DylanSlayton/Automated-Rock-Candy-Maker/Rock Candy Maker P&ID Spec Sheet Uploadable.xlsx

Sheet: Single Line Nozzle
Tag | Size | Spec | Description | Manufacturer | Model Number | Supplier | Comment | Class Name | PnPID | Status | Type | Number
N-1 |  |  | SINGLE LINE NOZZLE |  |  |  |  | Single Line Nozzle | 2215 | New | N | 1

Sheet: Flanged Nozzle
Tag | Size | Spec | Description | Manufacturer | Model Number | Supplier | Comment | Class Name | PnPID | Status | Type | Number
N-2 | 1/4" | NPT Brass | FLANGED NOZZLE |  |  |  |  | Flanged Nozzle | 2126 | New | N | 2
N-1 |  |  | FLANGED NOZZLE |  |  |  |  | Flanged Nozzle | 2396 | New | N | 1

Sheet: Assumed Nozzle
Tag | Size | Spec | Description | Manufacturer | Model Number | Supplier | Comment | Class Name | PnPID | Status | Type | Number
N-1 | 3/8" | Sch 40 PVC | ASSUMED NOZZLE |  |  |  |  | Assumed Nozzle | 2181 | New | N | 1
N-2 | 3/8" | Sch 40 PVC | ASSUMED NOZZLE |  |  |  |  | Assumed Nozzle | 2362 | New | N | 2

Sheet: Nozzles
Tag | Size | Spec | Description | Manufacturer | Model Number | Supplier | Comment | Class Name | PnPID | Status | Type | Number
N-2 | 1/4" | NPT Brass | FLANGED NOZZLE |  |  |  |  | Flanged Nozzle | 2126 | New | N | 2
N-1 | 3/8" | Sch 40 PVC | ASSUMED NOZZLE |  |  |  |  | Assumed Nozzle | 2181 | New | N | 1
N-1 |  |  | SINGLE LINE NOZZLE |  |  |  |  | Single Line Nozzle | 2215 | New | N | 1
N-2 | 3/8" | Sch 40 PVC | ASSUMED NOZZLE |  |  |  |  | Assumed Nozzle | 2362 | New | N | 2
N-1 |  |  | FLANGED NOZZLE |  |  |  |  | Flanged Nozzle | 2396 | New | N | 1

Sheet: Software Signal Line
Description | Manufacturer | Model Number | Supplier | Comment | Class Name | PnPID | Status | Tag | From | To
SOFTWARE SIGNAL LINE |  |  |  |  | Software Signal Line | 2654 | New | ? | 1-TALL-1 | 1-I-1?
SOFTWARE SIGNAL LINE |  |  |  |  | Software Signal Line | 2657 | New | ? | 1-TAL-1 | 1-I-2
SOFTWARE SIGNAL LINE |  |  |  |  | Software Signal Line | 2686 | New | ? | 1-I-2 | 1-I-3
SOFTWARE SIGNAL LINE |  |  |  |  | Software Signal Line | 2694 | New | ? | 1-I-3 | 1-I-4
SOFTWARE SIGNAL LINE |  |  |  |  | Software Signal Line | 2708 | New | ? |  | 1-I-5

Sheet: Instrument Supply
Description | Manufacturer | Model Number | Supplier | Comment | Class Name | PnPID | Status | Tag | From | To
INSTRUMENT SUPPLY |  |  |  |  | Instrument Supply | 2197 | New | ? |  | R-001

Sheet: Electrical Signal Line
Description | Manufacturer | Model Number | Supplier | Comment | Class Name | PnPID | Status | Tag | From | To
ELECTRICAL SIGNAL LINE |  |  |  |  | Electrical Signal Line | 2130 | New | ? | 1-LI-1?
ELECTRICAL SIGNAL LINE |  |  |  |  | Electrical Signal Line | 2143 | New | ? | 1-TT-1? | 1-TI-1?
ELECTRICAL SIGNAL LINE |  |  |  |  | Electrical Signal Line | 2174 | New | ? | P-001
ELECTRICAL SIGNAL LINE |  |  |  |  | Electrical Signal Line | 2188 | New | ? | 1-ZS-1? | M-001
ELECTRICAL SIGNAL LINE |  |  |  |  | Electrical Signal Line | 2209 | New | ? | 1-TI-1?
ELECTRICAL SIGNAL LINE |  |  |  |  | Electrical Signal Line | 2614 | New | ? | 1-TALL-1 | 1-TAH-1
ELECTRICAL SIGNAL LINE |  |  |  |  | Electrical Signal Line | 2648 | New | ? | 1-TC-1? | ?
ELECTRICAL SIGNAL LINE |  |  |  |  | Electrical Signal Line | 2717 | New | ? |  | 1-I-1?
ELECTRICAL SIGNAL LINE |  |  |  |  | Electrical Signal Line | 2724 | New | ? | 1-I-2
ELECTRICAL SIGNAL LINE |  |  |  |  | Electrical Signal Line | 2727 | New | ? | 1-I-5 | ?
ELECTRICAL SIGNAL LINE |  |  |  |  | Electrical Signal Line | 2736 | New | ? | ? | 1-I-4
ELECTRICAL SIGNAL LINE |  |  |  |  | Electrical Signal Line | 2740 | New | ? | M-003 | 1-I-5
ELECTRICAL SIGNAL LINE |  |  |  |  | Electrical Signal Line | 2743 | New | ? | ? | 1-TAL-1
ELECTRICAL SIGNAL LINE |  |  |  |  | Electrical Signal Line | 2917 | New | ? | 1-I-4 | 1-XV-1

Sheet: Capillary Tube
Description | Manufacturer | Model Number | Supplier | Comment | Class Name | PnPID | Status | Tag | From | To
CAPILLARY TUBE |  |  |  |  | Capillary Tube | 2701 | New | ? | 1-TW-1? | 1-TT-1?

Sheet: Signal Line Segments
Description | Manufacturer | Model Number | Supplier | Comment | Class Name | PnPID | Status | Tag | From | To
ELECTRICAL SIGNAL LINE |  |  |  |  | Electrical Signal Line | 2130 | New | ? | 1-LI-1?
ELECTRICAL SIGNAL LINE |  |  |  |  | Electrical Signal Line | 2143 | New | ? | 1-TT-1? | 1-TI-1?
ELECTRICAL SIGNAL LINE |  |  |  |  | Electrical Signal Line | 2174 | New | ? | P-001
ELECTRICAL SIGNAL LINE |  |  |  |  | Electrical Signal Line | 2188 | New | ? | 1-ZS-1? | M-001
INSTRUMENT SUPPLY |  |  |  |  | Instrument Supply | 2197 | New | ? |  | R-001
ELECTRICAL SIGNAL LINE |  |  |  |  | Electrical Signal Line | 2209 | New | ? | 1-TI-1?
ELECTRICAL SIGNAL LINE |  |  |  |  | Electrical Signal Line | 2614 | New | ? | 1-TALL-1 | 1-TAH-1
ELECTRICAL SIGNAL LINE |  |  |  |  | Electrical Signal Line | 2648 | New | ? | 1-TC-1? | ?
SOFTWARE SIGNAL LINE |  |  |  |  | Software Signal Line | 2654 | New | ? | 1-TALL-1 | 1-I-1?
SOFTWARE SIGNAL LINE |  |  |  |  | Software Signal Line | 2657 | New | ? | 1-TAL-1 | 1-I-2
SOFTWARE SIGNAL LINE |  |  |  |  | Software Signal Line | 2686 | New | ? | 1-I-2 | 1-I-3
SOFTWARE SIGNAL LINE |  |  |  |  | Software Signal Line | 2694 | New | ? | 1-I-3 | 1-I-4
CAPILLARY TUBE |  |  |  |  | Capillary Tube | 2701 | New | ? | 1-TW-1? | 1-TT-1?
SOFTWARE SIGNAL LINE |  |  |  |  | Software Signal Line | 2708 | New | ? |  | 1-I-5
ELECTRICAL SIGNAL LINE |  |  |  |  | Electrical Signal Line | 2717 | New | ? |  | 1-I-1?
ELECTRICAL SIGNAL LINE |  |  |  |  | Electrical Signal Line | 2724 | New | ? | 1-I-2
ELECTRICAL SIGNAL LINE |  |  |  |  | Electrical Signal Line | 2727 | New | ? | 1-I-5 | ?
ELECTRICAL SIGNAL LINE |  |  |  |  | Electrical Signal Line | 2736 | New | ? | ? | 1-I-4
ELECTRICAL SIGNAL LINE |  |  |  |  | Electrical Signal Line | 2740 | New | ? | M-003 | 1-I-5
ELECTRICAL SIGNAL LINE |  |  |  |  | Electrical Signal Line | 2743 | New | ? | ? | 1-TAL-1
ELECTRICAL SIGNAL LINE |  |  |  |  | Electrical Signal Line | 2917 | New | ? | 1-I-4 | 1-XV-1

Sheet: Signal Line Group
PnPID | Description | Comment
1839 | SIGNAL LINE GROUP
1842 | SIGNAL LINE GROUP
1846 | SIGNAL LINE GROUP
1850 | SIGNAL LINE GROUP
1851 | SIGNAL LINE GROUP
1852 | SIGNAL LINE GROUP
2613 | SIGNAL LINE GROUP
2650 | SIGNAL LINE GROUP
2656 | SIGNAL LINE GROUP
2659 | SIGNAL LINE GROUP
2688 | SIGNAL LINE GROUP
2696 | SIGNAL LINE GROUP
2703 | SIGNAL LINE GROUP
2710 | SIGNAL LINE GROUP
2719 | SIGNAL LINE GROUP
2726 | SIGNAL LINE GROUP
2729 | SIGNAL LINE GROUP
2742 | SIGNAL LINE GROUP
2919 | SIGNAL LINE GROUP

Sheet: Primary Line Segment - Existing
Tag | Size | Spec | To | From | Design Pressure | Design Temperature | Operating Temperature | Operating Pressure | Tracing | Insulation Type | Insulation Thickness | Paint Code | Testing Fluid | Test Pressure | PWHT | Description | Manufacturer | Model Number | Supplier | Comment | Class Name | PnPID | Status | Spec Part
?-?-?-?-? |  |  | M-001 | TK-002 |  |  |  |  |  |  |  |  |  |  |  | PRIMARY LINE SEGMENT - EXISTING |  |  |  |  | Primary Line Segment - Existing | 2391 | Existing
?-?-?-?-? |  |  |  | M-001 |  |  |  |  |  |  |  |  |  |  |  | PRIMARY LINE SEGMENT - EXISTING |  |  |  |  | Primary Line Segment - Existing | 2399 | Existing

Sheet: Primary Line Segment
Tag | Size | Spec | To | From | Design Pressure | Design Temperature | Operating Temperature | Operating Pressure | Tracing | Insulation Type | Insulation Thickness | Paint Code | Testing Fluid | Test Pressure | PWHT | Description | Manufacturer | Model Number | Supplier | Comment | Class Name | PnPID | Status | Spec Part
1/4"-NPT Brass-P-3-N | 1/4" | NPT Brass | ?-?-P-4 | R-001 |  |  |  |  |  | N | 0 |  |  |  |  | PRIMARY LINE SEGMENT |  |  |  |  | Primary Line Segment | 2110 | New
3/8"-Sch 40 PVC-DW-1-N | 3/8" | Sch 40 PVC | P-001 |  |  |  |  |  |  | N |  |  |  |  |  | PRIMARY LINE SEGMENT | ‎Feelers |  | QuQuyi |  | Primary Line Segment | 2140 | New | 0.38 Inch Sch 40 - PVC Pipe
?-?-P-4 |  |  |  | 1/4"-NPT Brass-P-3-N |  |  |  |  |  |  |  |  |  |  |  | PRIMARY LINE SEGMENT |  |  |  |  | Primary Line Segment | 2184 | New
3/8"-Sch 40 PVC-DW-2-N | 3/8" | Sch 40 PVC |  | P-001 |  |  |  |  |  | N |  |  |  |  |  | PRIMARY LINE SEGMENT |  |  |  |  | Primary Line Segment | 2353 | New | 0.38 Inch Sch 40 - PVC Pipe

Sheet: Pipe Line Segments
Tag | Size | Spec | To | From | Design Pressure | Design Temperature | Operating Temperature | Operating Pressure | Tracing | Insulation Type | Insulation Thickness | Paint Code | Testing Fluid | Test Pressure | PWHT | Description | Manufacturer | Model Number | Supplier | Comment | Class Name | PnPID | Status | Spec Part
1/4"-NPT Brass-P-3-N | 1/4" | NPT Brass | ?-?-P-4 | R-001 |  |  |  |  |  | N | 0 |  |  |  |  | PRIMARY LINE SEGMENT |  |  |  |  | Primary Line Segment | 2110 | New
3/8"-Sch 40 PVC-DW-1-N | 3/8" | Sch 40 PVC | P-001 |  |  |  |  |  |  | N |  |  |  |  |  | PRIMARY LINE SEGMENT | ‎Feelers |  | QuQuyi |  | Primary Line Segment | 2140 | New | 0.38 Inch Sch 40 - PVC Pipe
?-?-P-4 |  |  |  | 1/4"-NPT Brass-P-3-N |  |  |  |  |  |  |  |  |  |  |  | PRIMARY LINE SEGMENT |  |  |  |  | Primary Line Segment | 2184 | New
3/8"-Sch 40 PVC-DW-2-N | 3/8" | Sch 40 PVC |  | P-001 |  |  |  |  |  | N |  |  |  |  |  | PRIMARY LINE SEGMENT |  |  |  |  | Primary Line Segment | 2353 | New | 0.38 Inch Sch 40 - PVC Pipe
?-?-?-?-? |  |  | M-001 | TK-002 |  |  |  |  |  |  |  |  |  |  |  | PRIMARY LINE SEGMENT - EXISTING |  |  |  |  | Primary Line Segment - Existing | 2391 | Existing
?-?-?-?-? |  |  |  | M-001 |  |  |  |  |  |  |  |  |  |  |  | PRIMARY LINE SEGMENT - EXISTING |  |  |  |  | Primary Line Segment - Existing | 2399 | Existing

Sheet: Pipe Line Group
Line Number | Service | Nominal Size | Nominal Spec | Description | Comment | PnPID | Tag | Status
1 | DW |  |  | PIPE LINE GROUP |  | 781 | 1 | New
3 | P |  |  | PIPE LINE GROUP |  | 941 | 3 | New
2 | DW |  |  | PIPE LINE GROUP |  | 1011 | 2 | New
 |  |  |  | PIPE LINE GROUP |  | 2395 | ? | New
 |  |  |  | PIPE LINE GROUP |  | 2406 | ? | New

Sheet: Lines
Description | Manufacturer | Model Number | Supplier | Comment | Class Name | PnPID | Status
PRIMARY LINE SEGMENT |  |  |  |  | Primary Line Segment | 2110 | New
ELECTRICAL SIGNAL LINE |  |  |  |  | Electrical Signal Line | 2130 | New
PRIMARY LINE SEGMENT | ‎Feelers |  | QuQuyi |  | Primary Line Segment | 2140 | New
ELECTRICAL SIGNAL LINE |  |  |  |  | Electrical Signal Line | 2143 | New
ELECTRICAL SIGNAL LINE |  |  |  |  | Electrical Signal Line | 2174 | New
PRIMARY LINE SEGMENT |  |  |  |  | Primary Line Segment | 2184 | New
ELECTRICAL SIGNAL LINE |  |  |  |  | Electrical Signal Line | 2188 | New
INSTRUMENT SUPPLY |  |  |  |  | Instrument Supply | 2197 | New
ELECTRICAL SIGNAL LINE |  |  |  |  | Electrical Signal Line | 2209 | New
PRIMARY LINE SEGMENT |  |  |  |  | Primary Line Segment | 2353 | New
PRIMARY LINE SEGMENT - EXISTING |  |  |  |  | Primary Line Segment - Existing | 2391 | Existing
PRIMARY LINE SEGMENT - EXISTING |  |  |  |  | Primary Line Segment - Existing | 2399 | Existing
ELECTRICAL SIGNAL LINE |  |  |  |  | Electrical Signal Line | 2614 | New
ELECTRICAL SIGNAL LINE |  |  |  |  | Electrical Signal Line | 2648 | New
SOFTWARE SIGNAL LINE |  |  |  |  | Software Signal Line | 2654 | New
SOFTWARE SIGNAL LINE |  |  |  |  | Software Signal Line | 2657 | New
SOFTWARE SIGNAL LINE |  |  |  |  | Software Signal Line | 2686 | New
SOFTWARE SIGNAL LINE |  |  |  |  | Software Signal Line | 2694 | New
CAPILLARY TUBE |  |  |  |  | Capillary Tube | 2701 | New
SOFTWARE SIGNAL LINE |  |  |  |  | Software Signal Line | 2708 | New
ELECTRICAL SIGNAL LINE |  |  |  |  | Electrical Signal Line | 2717 | New
ELECTRICAL SIGNAL LINE |  |  |  |  | Electrical Signal Line | 2724 | New
ELECTRICAL SIGNAL LINE |  |  |  |  | Electrical Signal Line | 2727 | New
ELECTRICAL SIGNAL LINE |  |  |  |  | Electrical Signal Line | 2736 | New
ELECTRICAL SIGNAL LINE |  |  |  |  | Electrical Signal Line | 2740 | New
ELECTRICAL SIGNAL LINE |  |  |  |  | Electrical Signal Line | 2743 | New
ELECTRICAL SIGNAL LINE |  |  |  |  | Electrical Signal Line | 2917 | New

Sheet: Ultrasonic
Tag | Area | Type | Loop Number | Location | Size | Description | Manufacturer | Model Number | Supplier | Comment | Class Name | PnPID | Status | End Connections
1-LI-1? | 1 | LI | 1 |  |  | ULTRASONIC | WWZMDiB | HC-SR04 | WWZMDiB |  | Ultrasonic | 2185 |  | Unspecified

Sheet: Control Valve
Tag | Area | Type | Loop Number | Location | Size | Description | Manufacturer | Model Number | Supplier | Valve Code | Normally | Failure | Body Type | Actuator Type | Comment | Class Name | PnPID | Status | End Connections
1-XV-1 | 1 | XV | 1 |  | 1/4" | CONTROL VALVE |  |  |  |  | NO |  | Gate Valve | Solenoid |  | Control Valve | 2151 | New | Unspecified

Sheet: Inline Instruments
Tag | Area | Type | Loop Number | Location | Size | Description | Manufacturer | Model Number | Supplier | Comment | Class Name | PnPID | Status | End Connections
1-XV-1 | 1 | XV | 1 |  | 1/4" | CONTROL VALVE |  |  |  |  | Control Valve | 2151 | New | Unspecified
1-LI-1? | 1 | LI | 1 |  |  | ULTRASONIC | WWZMDiB | HC-SR04 | WWZMDiB |  | Ultrasonic | 2185 |  | Unspecified

Sheet: Primary Accessible DCS
Tag | Area | Type | Loop Number | Location | Description | Manufacturer | Model Number | Supplier | Comment | Class Name | PnPID | Status
1-FC-1? | 1 | FC | 1 | DCS | PRIMARY ACCESSIBLE DCS |  |  |  |  | Primary Accessible DCS | 2141 | New
1-ZS-1? | 1 | ZS | 1 | DCS | PRIMARY ACCESSIBLE DCS |  |  |  |  | Primary Accessible DCS | 2159 | New

Sheet: Field Discrete Instrument
Tag | Area | Type | Loop Number | Location | Description | Manufacturer | Model Number | Supplier | Comment | Class Name | PnPID | Status
1-TW-1? | 1 | TW | 1 |  | FIELD DISCRETE INSTRUMENT | HiLetgo | ‎ 3-01-1104-B | Amazon | K Type Thermocouple | Field Discrete Instrument | 2102 | New
1-TT-1? | 1 | TT | 1 |  | FIELD DISCRETE INSTRUMENT | HiLetgo | MAX6675 | Amazon | Amplifier | Field Discrete Instrument | 2104 | New

Sheet: Field DCS
Tag | Area | Type | Loop Number | Location | Description | Manufacturer | Model Number | Supplier | Comment | Class Name | PnPID | Status
1-TI-1? | 1 | TI | 1 | DCS | FIELD DCS |  |  |  |  | Field DCS | 2158 | New
1-TAH-1 | 1 | TAH | 1 | DCS | FIELD DCS |  |  |  |  | Field DCS | 2212 | New
1-TC-1? | 1 | TC | 1 | DCS | FIELD DCS |  |  |  |  | Field DCS | 2214 | New
1-TAL-1 | 1 | TAL | 1 | DCS | FIELD DCS |  |  |  |  | Field DCS | 2602 | New
1-TALL-1 | 1 | TALL | 1 | DCS | FIELD DCS |  |  |  |  | Field DCS | 2624 | New

Sheet: Discrete Hardware Interlock
Tag | Area | Type | Loop Number | Location | Description | Manufacturer | Model Number | Supplier | Comment | Class Name | PnPID | Status
1-I-1? | 1 | I | 1 |  | DISCRETE HARDWARE INTERLOCK |  |  |  |  | Discrete Hardware Interlock | 2156 | New
1-I-2 | 1 | I | 2 |  | DISCRETE HARDWARE INTERLOCK |  |  |  |  | Discrete Hardware Interlock | 2633 | New
1-I-3 | 1 | I | 3 |  | DISCRETE HARDWARE INTERLOCK |  |  |  |  | Discrete Hardware Interlock | 2661 | New
1-I-4 | 1 | I | 4 |  | DISCRETE HARDWARE INTERLOCK |  |  |  |  | Discrete Hardware Interlock | 2692 | New
1-I-5 | 1 | I | 5 |  | DISCRETE HARDWARE INTERLOCK |  |  |  |  | Discrete Hardware Interlock | 2706 | New

Sheet: General Instrument Symbols
Tag | Area | Type | Loop Number | Location | Description | Manufacturer | Model Number | Supplier | Comment | Class Name | PnPID | Status
1-TW-1? | 1 | TW | 1 |  | FIELD DISCRETE INSTRUMENT | HiLetgo | ‎ 3-01-1104-B | Amazon | K Type Thermocouple | Field Discrete Instrument | 2102 | New
1-TT-1? | 1 | TT | 1 |  | FIELD DISCRETE INSTRUMENT | HiLetgo | MAX6675 | Amazon | Amplifier | Field Discrete Instrument | 2104 | New
1-FC-1? | 1 | FC | 1 | DCS | PRIMARY ACCESSIBLE DCS |  |  |  |  | Primary Accessible DCS | 2141 | New
1-I-1? | 1 | I | 1 |  | DISCRETE HARDWARE INTERLOCK |  |  |  |  | Discrete Hardware Interlock | 2156 | New
1-TI-1? | 1 | TI | 1 | DCS | FIELD DCS |  |  |  |  | Field DCS | 2158 | New
1-ZS-1? | 1 | ZS | 1 | DCS | PRIMARY ACCESSIBLE DCS |  |  |  |  | Primary Accessible DCS | 2159 | New
1-TAH-1 | 1 | TAH | 1 | DCS | FIELD DCS |  |  |  |  | Field DCS | 2212 | New
1-TC-1? | 1 | TC | 1 | DCS | FIELD DCS |  |  |  |  | Field DCS | 2214 | New
1-TAL-1 | 1 | TAL | 1 | DCS | FIELD DCS |  |  |  |  | Field DCS | 2602 | New
1-TALL-1 | 1 | TALL | 1 | DCS | FIELD DCS |  |  |  |  | Field DCS | 2624 | New
1-I-2 | 1 | I | 2 |  | DISCRETE HARDWARE INTERLOCK |  |  |  |  | Discrete Hardware Interlock | 2633 | New
1-I-3 | 1 | I | 3 |  | DISCRETE HARDWARE INTERLOCK |  |  |  |  | Discrete Hardware Interlock | 2661 | New
1-I-4 | 1 | I | 4 |  | DISCRETE HARDWARE INTERLOCK |  |  |  |  | Discrete Hardware Interlock | 2692 | New
1-I-5 | 1 | I | 5 |  | DISCRETE HARDWARE INTERLOCK |  |  |  |  | Discrete Hardware Interlock | 2706 | New

Sheet: Instrumentation
Tag | Area | Type | Loop Number | Location | Description | Manufacturer | Model Number | Supplier | Comment | Class Name | PnPID | Status
1-TW-1? | 1 | TW | 1 |  | FIELD DISCRETE INSTRUMENT | HiLetgo | ‎ 3-01-1104-B | Amazon | K Type Thermocouple | Field Discrete Instrument | 2102 | New
1-TT-1? | 1 | TT | 1 |  | FIELD DISCRETE INSTRUMENT | HiLetgo | MAX6675 | Amazon | Amplifier | Field Discrete Instrument | 2104 | New
1-FC-1? | 1 | FC | 1 | DCS | PRIMARY ACCESSIBLE DCS |  |  |  |  | Primary Accessible DCS | 2141 | New
1-XV-1 | 1 | XV | 1 |  | CONTROL VALVE |  |  |  |  | Control Valve | 2151 | New
1-I-1? | 1 | I | 1 |  | DISCRETE HARDWARE INTERLOCK |  |  |  |  | Discrete Hardware Interlock | 2156 | New
1-TI-1? | 1 | TI | 1 | DCS | FIELD DCS |  |  |  |  | Field DCS | 2158 | New
1-ZS-1? | 1 | ZS | 1 | DCS | PRIMARY ACCESSIBLE DCS |  |  |  |  | Primary Accessible DCS | 2159 | New
1-LI-1? | 1 | LI | 1 |  | ULTRASONIC | WWZMDiB | HC-SR04 | WWZMDiB |  | Ultrasonic | 2185
1-TAH-1 | 1 | TAH | 1 | DCS | FIELD DCS |  |  |  |  | Field DCS | 2212 | New
1-TC-1? | 1 | TC | 1 | DCS | FIELD DCS |  |  |  |  | Field DCS | 2214 | New
1-TAL-1 | 1 | TAL | 1 | DCS | FIELD DCS |  |  |  |  | Field DCS | 2602 | New
1-TALL-1 | 1 | TALL | 1 | DCS | FIELD DCS |  |  |  |  | Field DCS | 2624 | New
1-I-2 | 1 | I | 2 |  | DISCRETE HARDWARE INTERLOCK |  |  |  |  | Discrete Hardware Interlock | 2633 | New
1-I-3 | 1 | I | 3 |  | DISCRETE HARDWARE INTERLOCK |  |  |  |  | Discrete Hardware Interlock | 2661 | New
1-I-4 | 1 | I | 4 |  | DISCRETE HARDWARE INTERLOCK |  |  |  |  | Discrete Hardware Interlock | 2692 | New
1-I-5 | 1 | I | 5 |  | DISCRETE HARDWARE INTERLOCK |  |  |  |  | Discrete Hardware Interlock | 2706 | New
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
