DylanSlayton/Automated-Rock-Candy-Maker/Sugar Dispenser v19.3mf

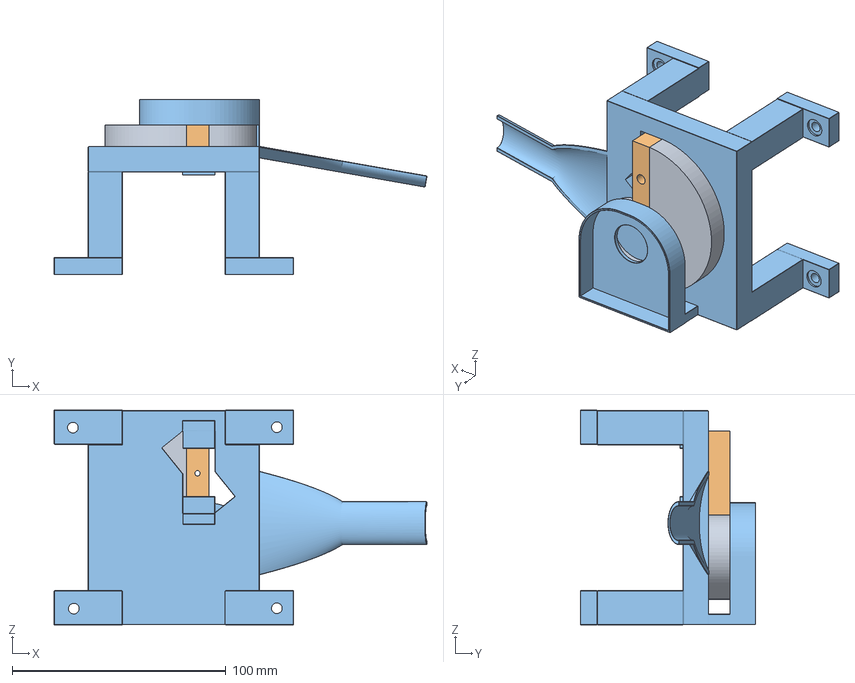
[picture p2: CAD file, 2025-03-09]
Sugar Dispenser v19.3mf
174.3 x 82.0 x 100.4 mm
