DylanSlayton/Automated-Rock-Candy-Maker/Stir Magnet Holder v9.3mf

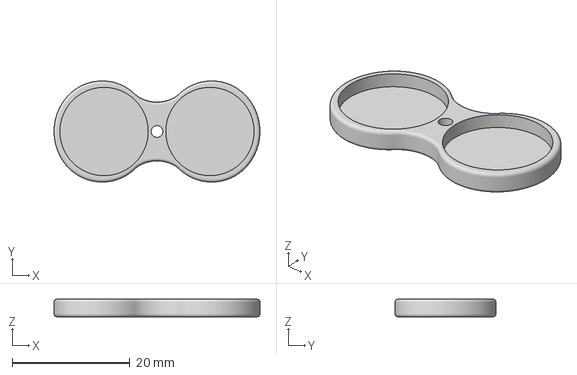
[picture p3: CAD file, 2025-03-09]
Stir Magnet Holder v9.3mf
35.0 x 17.2 x 3.00 mm
