DylanSlayton/Automated-Rock-Candy-Maker/Electrical Diagram.pdf

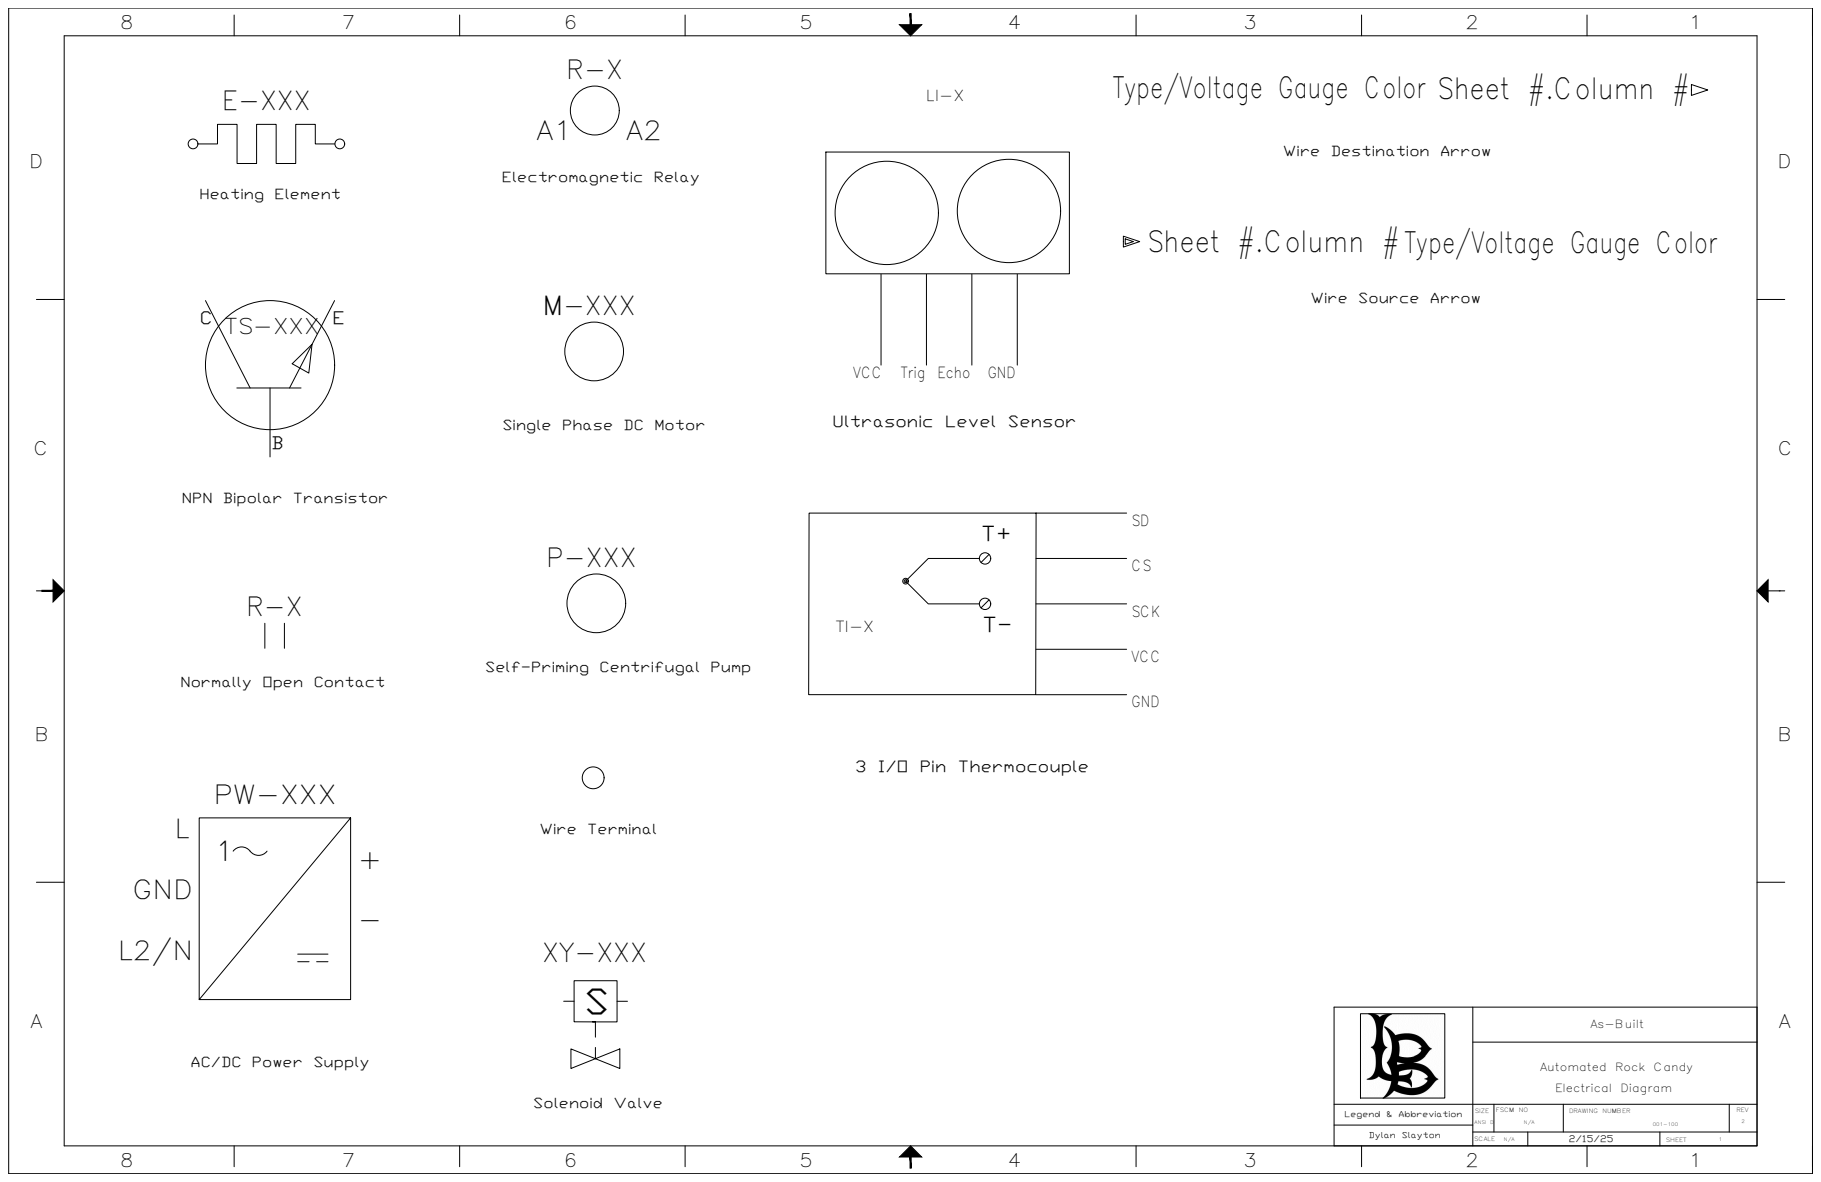
[picture p4: page 1]
SIZE; FSCM NO; DRAWING NUMBER; REV; ANSI D; Solenoid Valve; Heating Element; Electromagnetic Relay; 3 I/O Pin Thermocouple; Wire Terminal; Legend & Abbreviation; Dylan Slayton

Type/Voltage Gauge Color Sheet #.Column #

Wire Destination Arrow

Sheet #.Column # Type/Voltage Gauge Color

Wire Source Arrow

VCC Trig Echo GND

Ultrasonic Level Sensor

Single Phase DC Motor

NPN Bipolar Transistor

Self-Priming Centrifugal Pump

Normally Open Contact

AC/DC Power Supply

Automated Rock Candy
Electrical Diagram

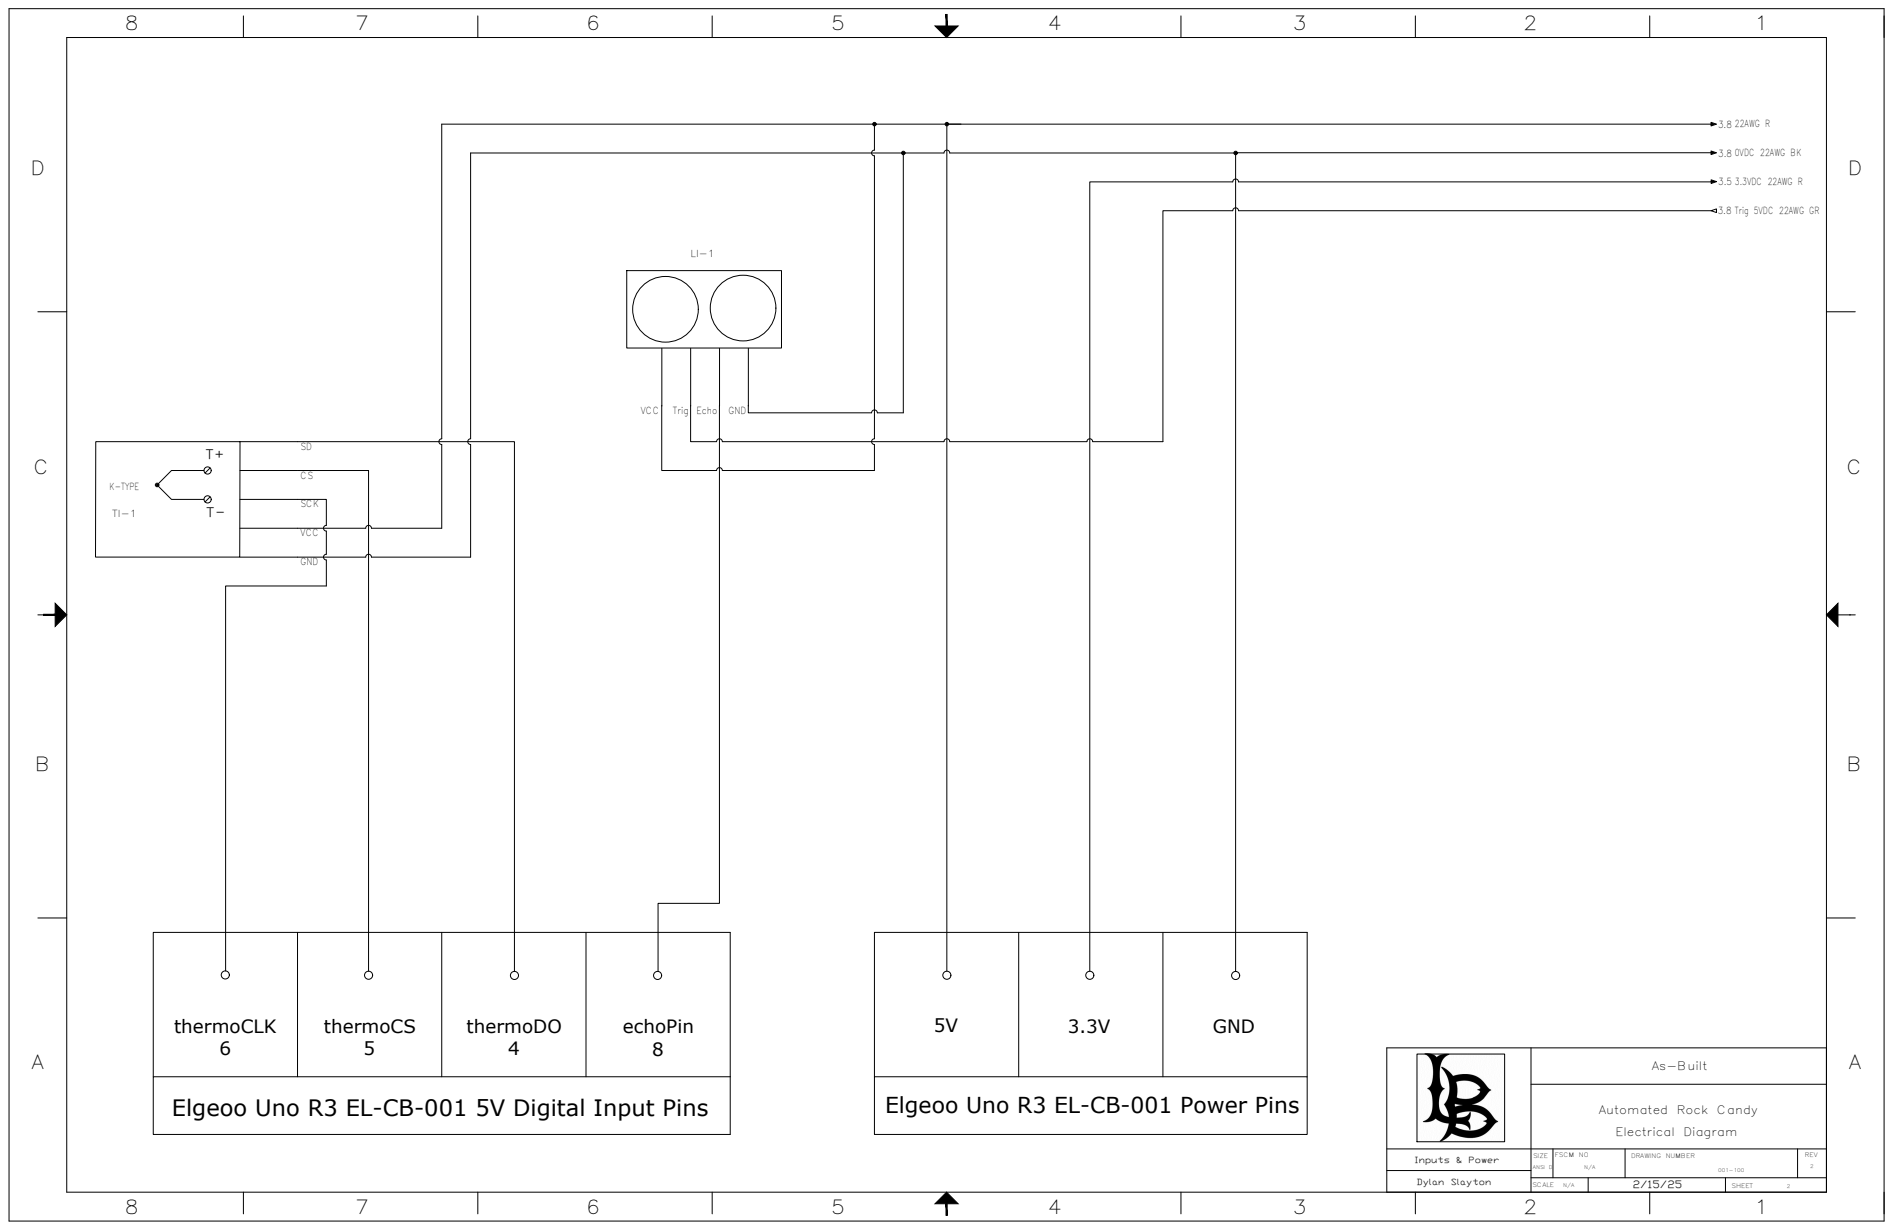
[picture p5: page 2]
3.8 0VDC 22AWG BK; 3.5 3.3VDC 22AWG R; 3.8 22AWG R; 3.8 Trig 5VDC 22AWG GR; Inputs & Power

SCK

Elgeoo Uno R3 EL-CB-001 5V Digital Input Pins

Elgeoo Uno R3 EL-CB-001 Power Pins

Automated Rock Candy
Electrical Diagram

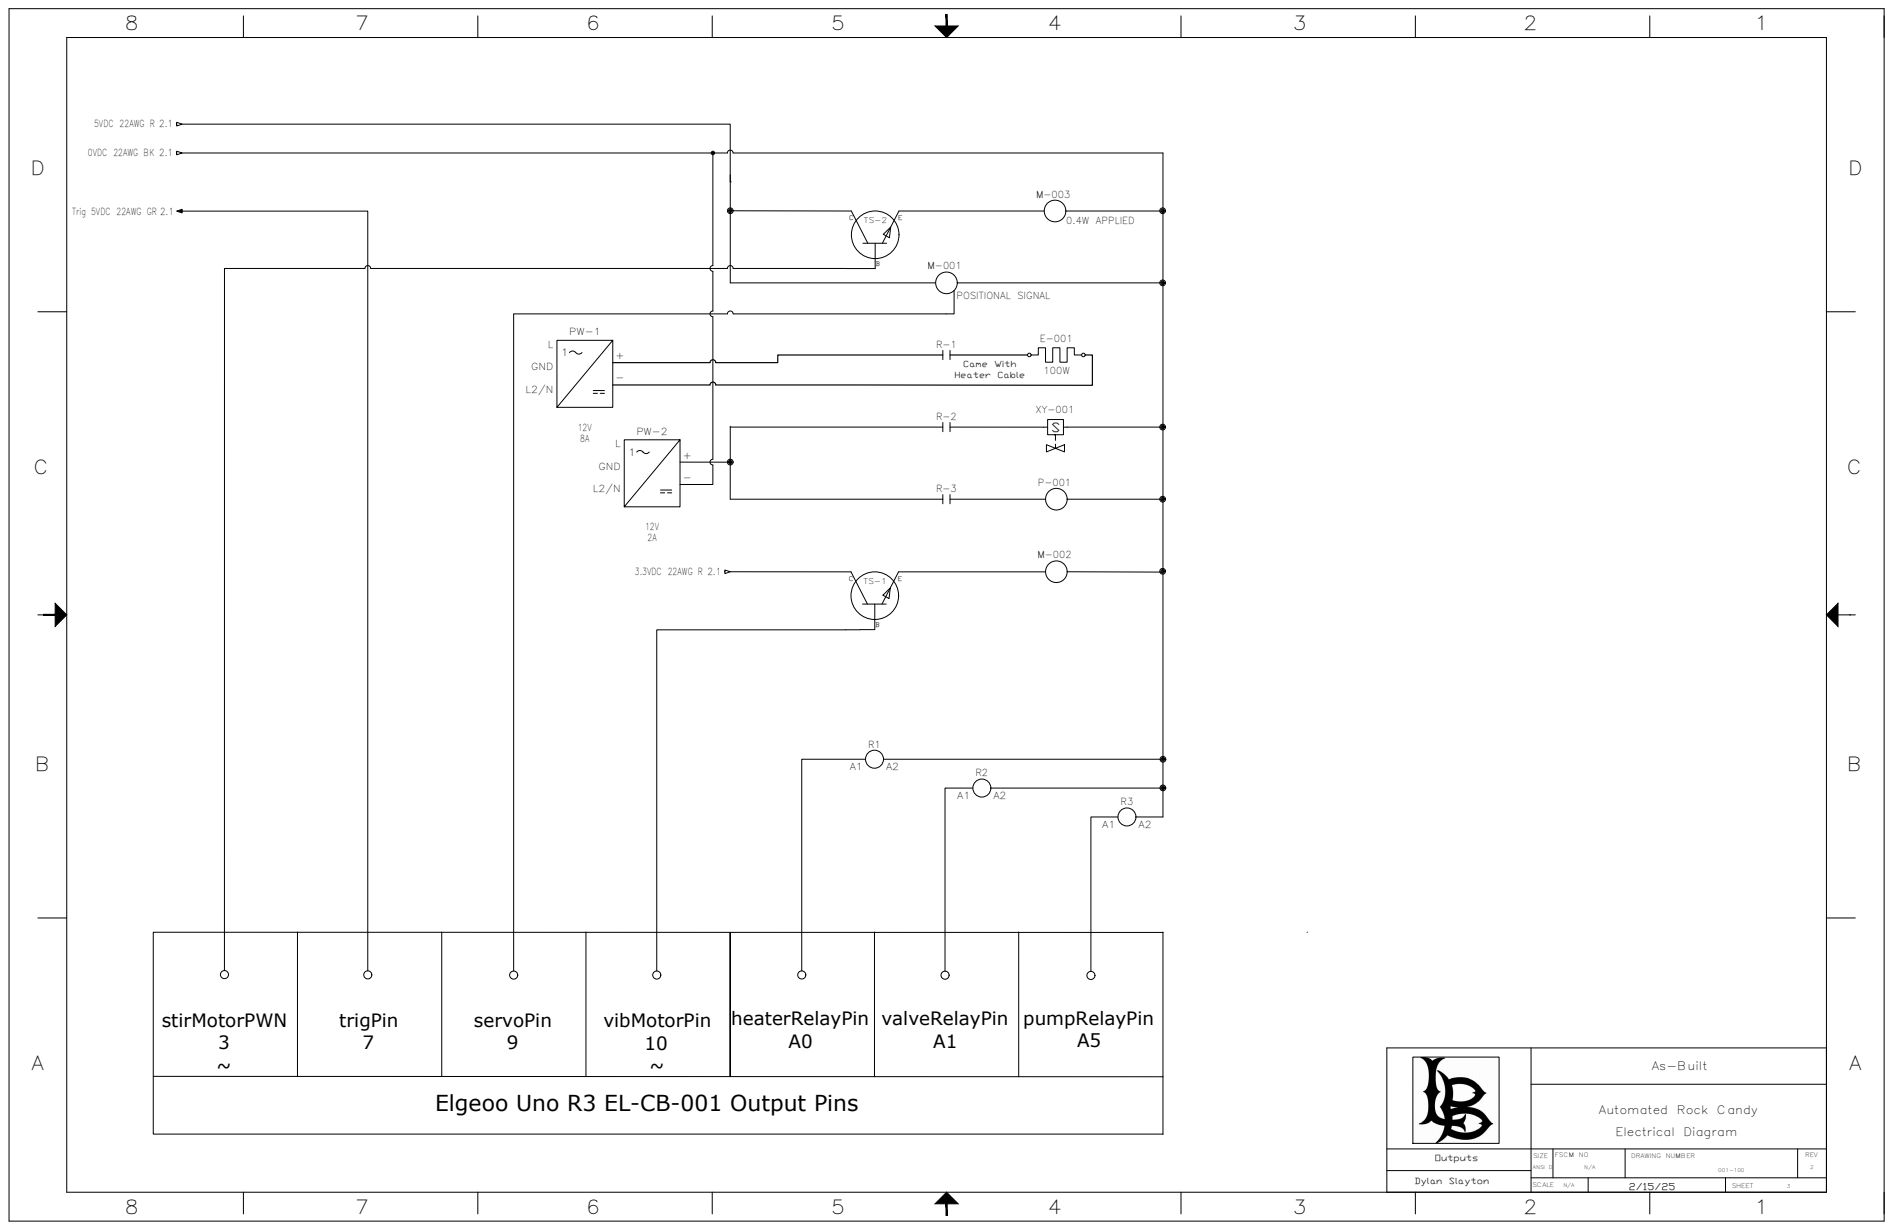
[picture p6: page 3]
0.4W APPLIED; POSITIONAL SIGNAL; Came With Heater Cable; Trig 5VDC 22AWG GR 2.1; 3.3VDC 22AWG R 2.1; 0VDC 22AWG BK 2.1; 5VDC 22AWG R 2.1

Elgeoo Uno R3 EL-CB-001 Output Pins

Automated Rock Candy
Electrical Diagram
