DylanSlayton/Automated-Rock-Candy-Maker/P&ID.pdf

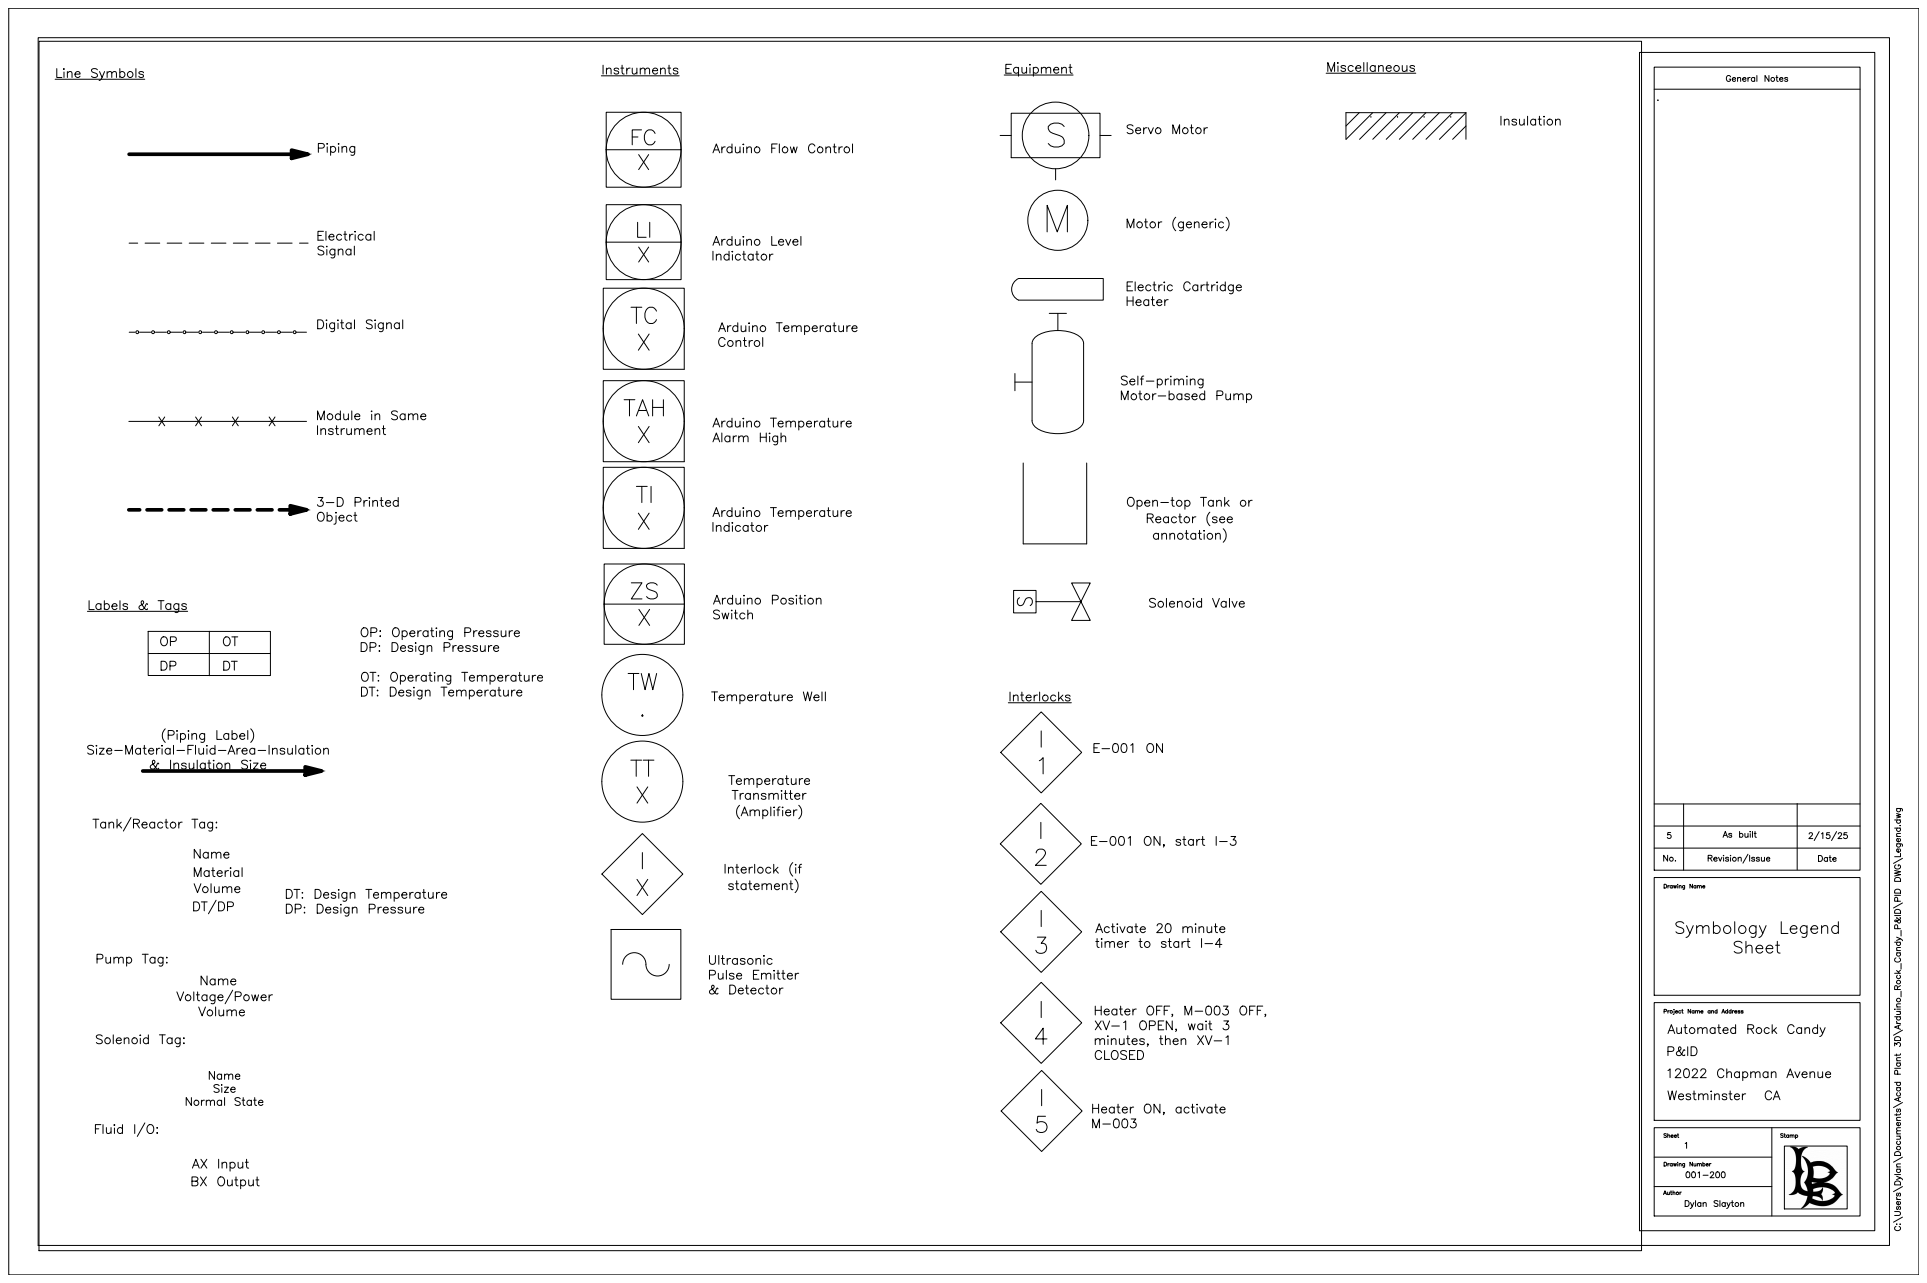
[picture p7: page 1]

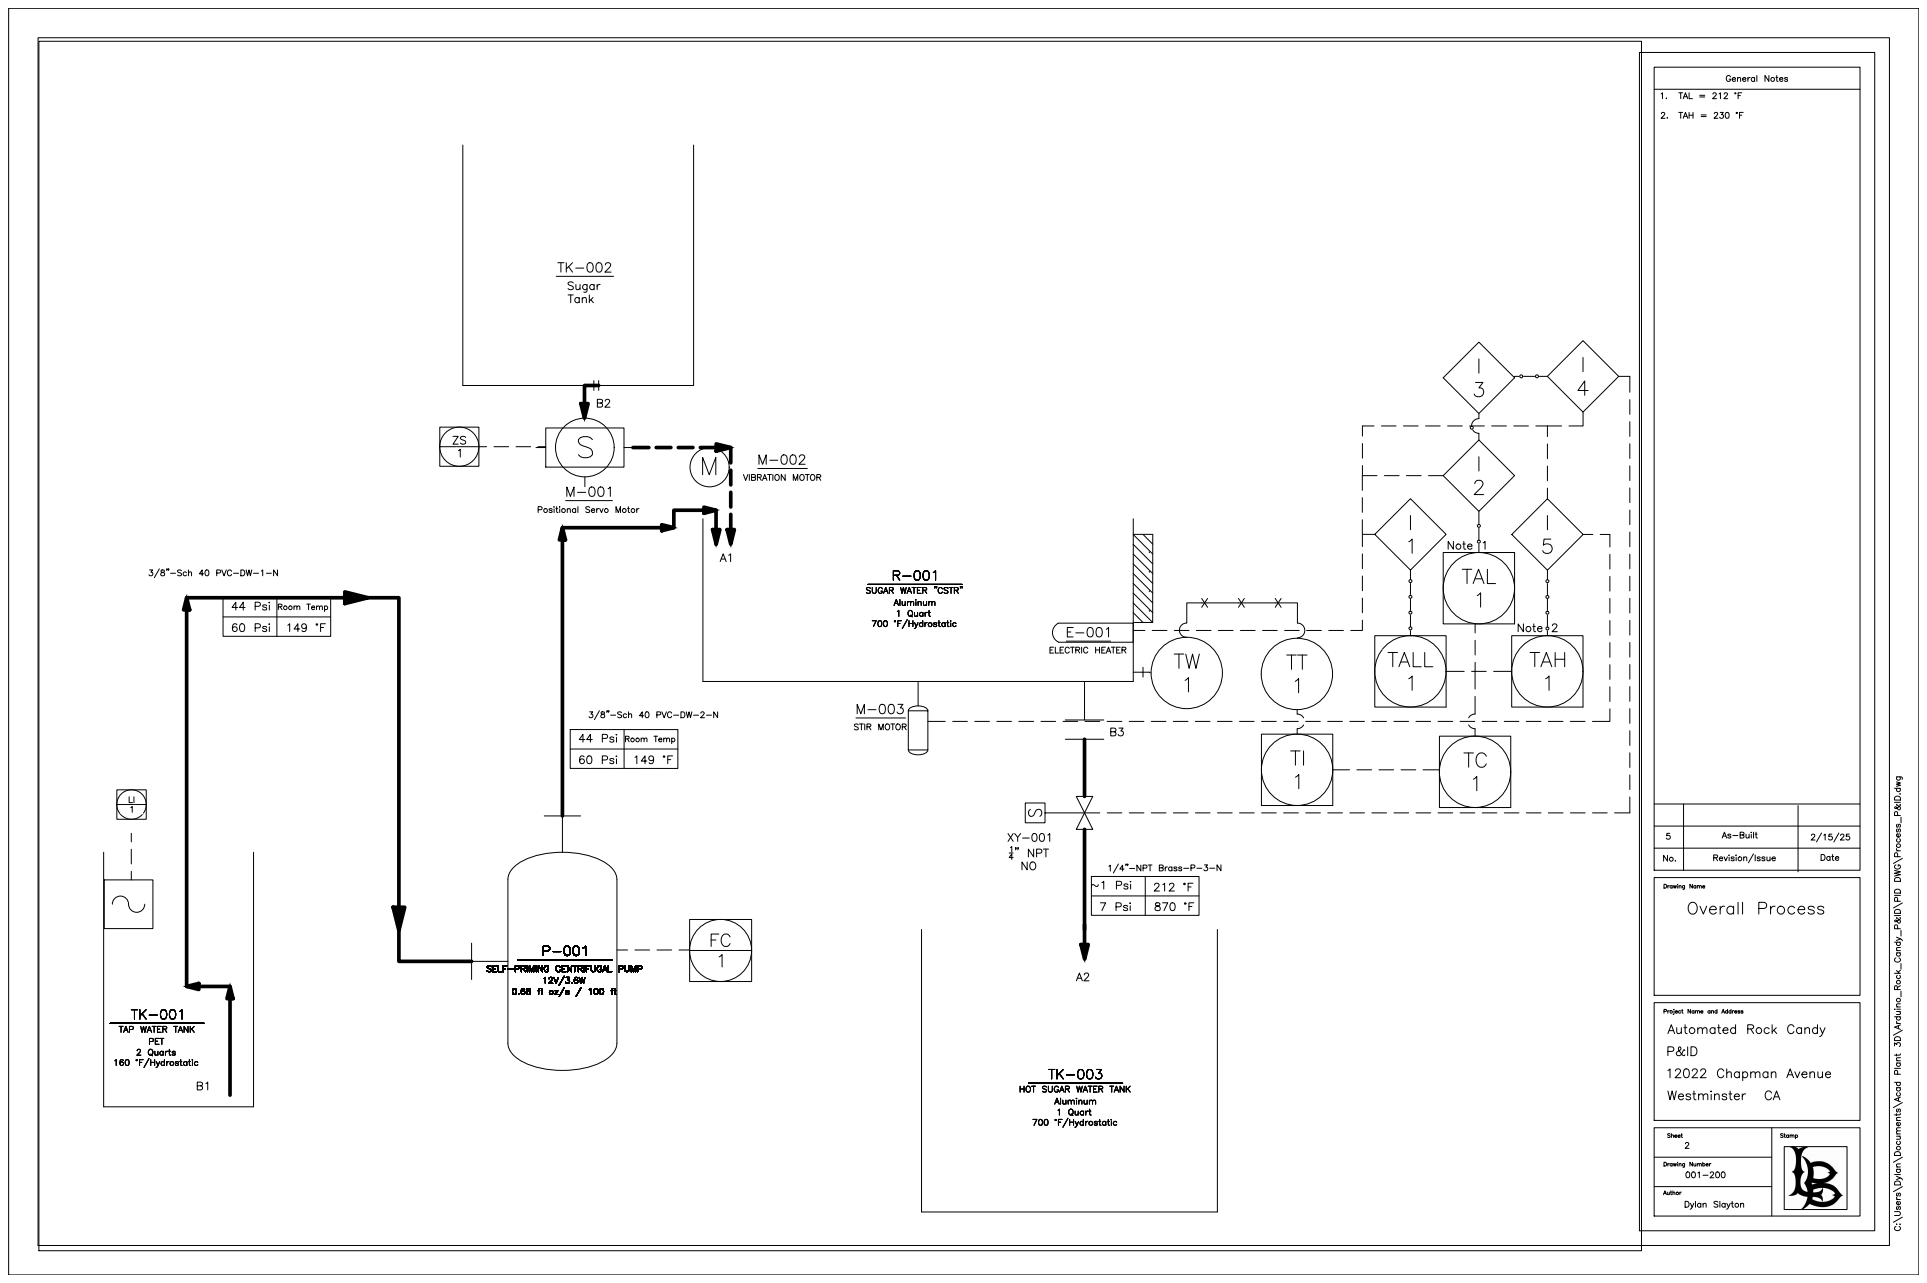
[picture p8: page 2]
