DylanSlayton/Automated-Rock-Candy-Maker/(commit log)

2025-03-09 3-D models used
    [Stir Magnet Holder v9.3mf, Sugar Dispenser v19.3mf]
2025-03-09 Schematics As-Built Drafts
    Disclaimer: Electrical Diagram is not reflective of the actual circuit but is functionally identical
    Originally drafts of the project before assembly, then revised to as-built to be updated with changes made to the physical apparatus. The P&ID has an excess of information displayed for quick reference because I prefer it over searching through the Rock Candy Maker P&ID Spec Sheet. The Electrical Diagram and P&ID were made using AutoCAD Electrical and AutoCAD Plant 3D respectively
2025-03-09 Spec Sheet of All Equipment
    Disclaimer: Does not include the two transistors used and wires from the Electrical Diagram
    The master document of information in the P&ID, includes dimensions in Imperial units, tags, supplier I sourced from, manufacturer, model number, my comments, and any info that is relevant to the specific equipment.
    [Rock Candy Maker P&ID Spec Sheet Uploadable.xlsx]
2025-04-03 Schematics As-Built
